SeBassTian23/ESP32-WeatherDisplay/(threads)

Thread 1 (2020-07-31):

One sensor

GlebDen, 2020-07-31:
Hello!
Very interesting project!
I just want to ask why don't you using one pcb with all 3 sensors like CJMCU-8128 (board with CCS811, BMP280 and SI702x)?
Thank you.

p.s. It's not an issue but I don't understand how to label this message as 'enhancement' for example :(

SeBassTian23, 2020-08-11:
Hi @GlebDen,

I'm glad you like the project! That is a very interesting breakout board. The reason I used three breakout boards is very simple. I just had them lying around and wanted to use them before buying something new. I also added the label enhancement 😄 .

Best

Closed 2020-08-31.
