SeBassTian23/ESP32-WeatherDisplay/include/cardinal_directions.h

#ifndef CARDINALDIR_H_
#define CARDINALDIR_H_

const int NUMBER_OF_ELEMENTS = 17;
const int MAX_SIZE = 4;

char cardinalDirections [NUMBER_OF_ELEMENTS] [MAX_SIZE] = { 
  {"N"},
  {"NNE"},
  {"NE"},
  {"ENE"},
  {"E"},
  {"ESE"},
  {"SE"},
  {"SSE"},
  {"S"},
  {"SSW"},
  {"SW"},
  {"WSW"},
  {"W"},
  {"WNW"},
  {"NW"},
  {"NNW"},
  {"N"}
 };

#endif
