SeBassTian23/ESP32-WeatherDisplay/include/forecast.h

#ifndef FORECAST_H_
#define FORECAST_H_

  struct Forecast_type {
    time_t        time;
    const char*   summary;
    const char*   icon;
    int           id;
    float         temperatureMin;
    float         temperatureMax;
  };

#endif
