SeBassTian23/ESP32-WeatherDisplay/include/hourly.h

#ifndef HOURLY_H_
#define HOURLY_H_

  struct Hourly_type {
    float        temperature;
    float        apparentTemperature;
    float        humidity;
    float        precipProbability;
  };

#endif
