SeBassTian23/ESP32-WeatherDisplay/(commit log)

2020-06-25 battery empty icon
2020-06-25 add x-axis labels for graphs
2020-06-25 Update current weather layout
2020-06-25 Update layout for sensor data display
2020-06-25 Use new BMP280 sensor
2020-06-25 Power management
2020-06-25 indicate battery status
2020-07-29 show battery low icon when ADC value drops below 2000
    also remove the voltage and value
2024-07-05 Change library to fix HTU21D
    [main.cpp]
